YukiOrigane/Pneumatic_Measurement/部品表.xlsx

 | 品名 | 型番 | 仕様 | 員数 | 単位 | リンク | 購入元
1 | コンデンサ | 50PX100MEFC8X11.5 | 100uF50V | 3 | 個 | https://akizukidenshi.com/catalog/g/g117905/ | 秋月電子
2 | チップコンデンサ | GRM188F11H104ZA01 | 0.1uF50V | 1 | パック | https://akizukidenshi.com/catalog/g/g113374/ | 秋月電子 | 1パック40個入
3 | チップLED | OSTG1608C1A | 1608 | 1 | パック | https://akizukidenshi.com/catalog/g/g106417/ | 秋月電子 | 1パック20個入
4 | DCジャック | MJ-179PH | 2.1mm | 3 | 個 | https://akizukidenshi.com/catalog/g/g106568/ | 秋月電子
5 | ACアダプタ | AD-B240P100 | 24V1A | 1 | 個 | https://akizukidenshi.com/catalog/g/g110658/ | 秋月電子
6 | PHコネクタ | B4B-PH-K-S | トップ型 4P | 20 | 個 | https://akizukidenshi.com/catalog/g/g112804/ | 秋月電子
7 | PHコネクタ | PHR-4 | 4P | 20 | 個 | https://akizukidenshi.com/catalog/g/g112797/ | 秋月電子
8 | PHコネクタ | SPH-002T-P0.5L | SPH-002T-P0.5L | 2 | パック | https://akizukidenshi.com/catalog/g/g112837/ | 秋月電子
9 | PHコネクタ | PHR-5 | 5P | 20 | 個 | https://akizukidenshi.com/catalog/g/g112798/ | 秋月電子
10 | PHコネクタ | B5B-PH-K-S | トップ型 5P | 20 | 個 | https://akizukidenshi.com/catalog/g/g112805 | 秋月電子
11 | XHコネクタ | B2B-XH-A(LF)(SN) | トップ型 2P | 20 | 個 | https://akizukidenshi.com/catalog/g/g112247/ | 秋月電子
12 | XHコネクタ | XHP-2 | ２P | 20 | 個 | https://akizukidenshi.com/catalog/g/g112255/ | 秋月電子
13 | XHコネクタ | XHP-4 | 4P | 20 | 個 | https://akizukidenshi.com/catalog/g/g112257/ | 秋月電子
14 | XHコネクタ | B4B-XH-A(LF)(SN) | トップ型 4P | 20 | 個 | https://akizukidenshi.com/catalog/g/g112249/ | 秋月電子
15 | XHコネクタ | SXH-001T-P0.6 | SXH-001T-P0.6 | 1 | パック | https://akizukidenshi.com/catalog/g/g112265/ | 秋月電子
16 | NchMOSFET | BSS138 | 50V300mA | 1 | パック | https://akizukidenshi.com/catalog/g/g104232/ | 秋月電子 | 1パック25個入
17 | DAコンバーター | MCP4726A0T-E/CH | 12bit | 3 | 個 | https://akizukidenshi.com/catalog/g/g107611/ | 秋月電子
18 | 低損失レギュレーター | MCP1792T-5002H/CB | 5V100mA | 3 | 個 | https://akizukidenshi.com/catalog/g/g115756/ | 秋月電子
19 | チップ抵抗 | RK73B1JTTD104J | 1608 1/10W100kΩ | 1 | パック | https://akizukidenshi.com/catalog/g/g130357/ | 秋月電子 | 1パック100個入
20 | マイコンボード | CXD5602PWBMAIN1 | SONY SPRESENSE | 2 | 個 | https://akizukidenshi.com/catalog/g/g114584/ | 秋月電子
21 | マイコンボード | CXD5602PWBEXT1 | SONY SPRESENSE 拡張ボード | 2 | 個 | https://akizukidenshi.com/catalog/g/g114585/ | 秋月電子
22 | ピンソケット | FH-10+8-M | 10P+8P リード長14.3mm | 2 | 個 | https://akizukidenshi.com/catalog/g/g117102/ | 秋月電子
23 | ピンソケット | FH-8+6-M | 8P+6P リード長14.3mm | 2 | 個 | https://akizukidenshi.com/catalog/g/g117103/ | 秋月電子
24 | USBケーブル | USB CABLE A-MICROB(2A L0.5m) | USB2.0 Aオス-マイクロBオス 0.5m A-microB | 2 | 本 | https://akizukidenshi.com/catalog/g/g109314/ | 秋月電子
