YukiOrigane/Pneumatic_Measurement/circuit/回路図.pdf

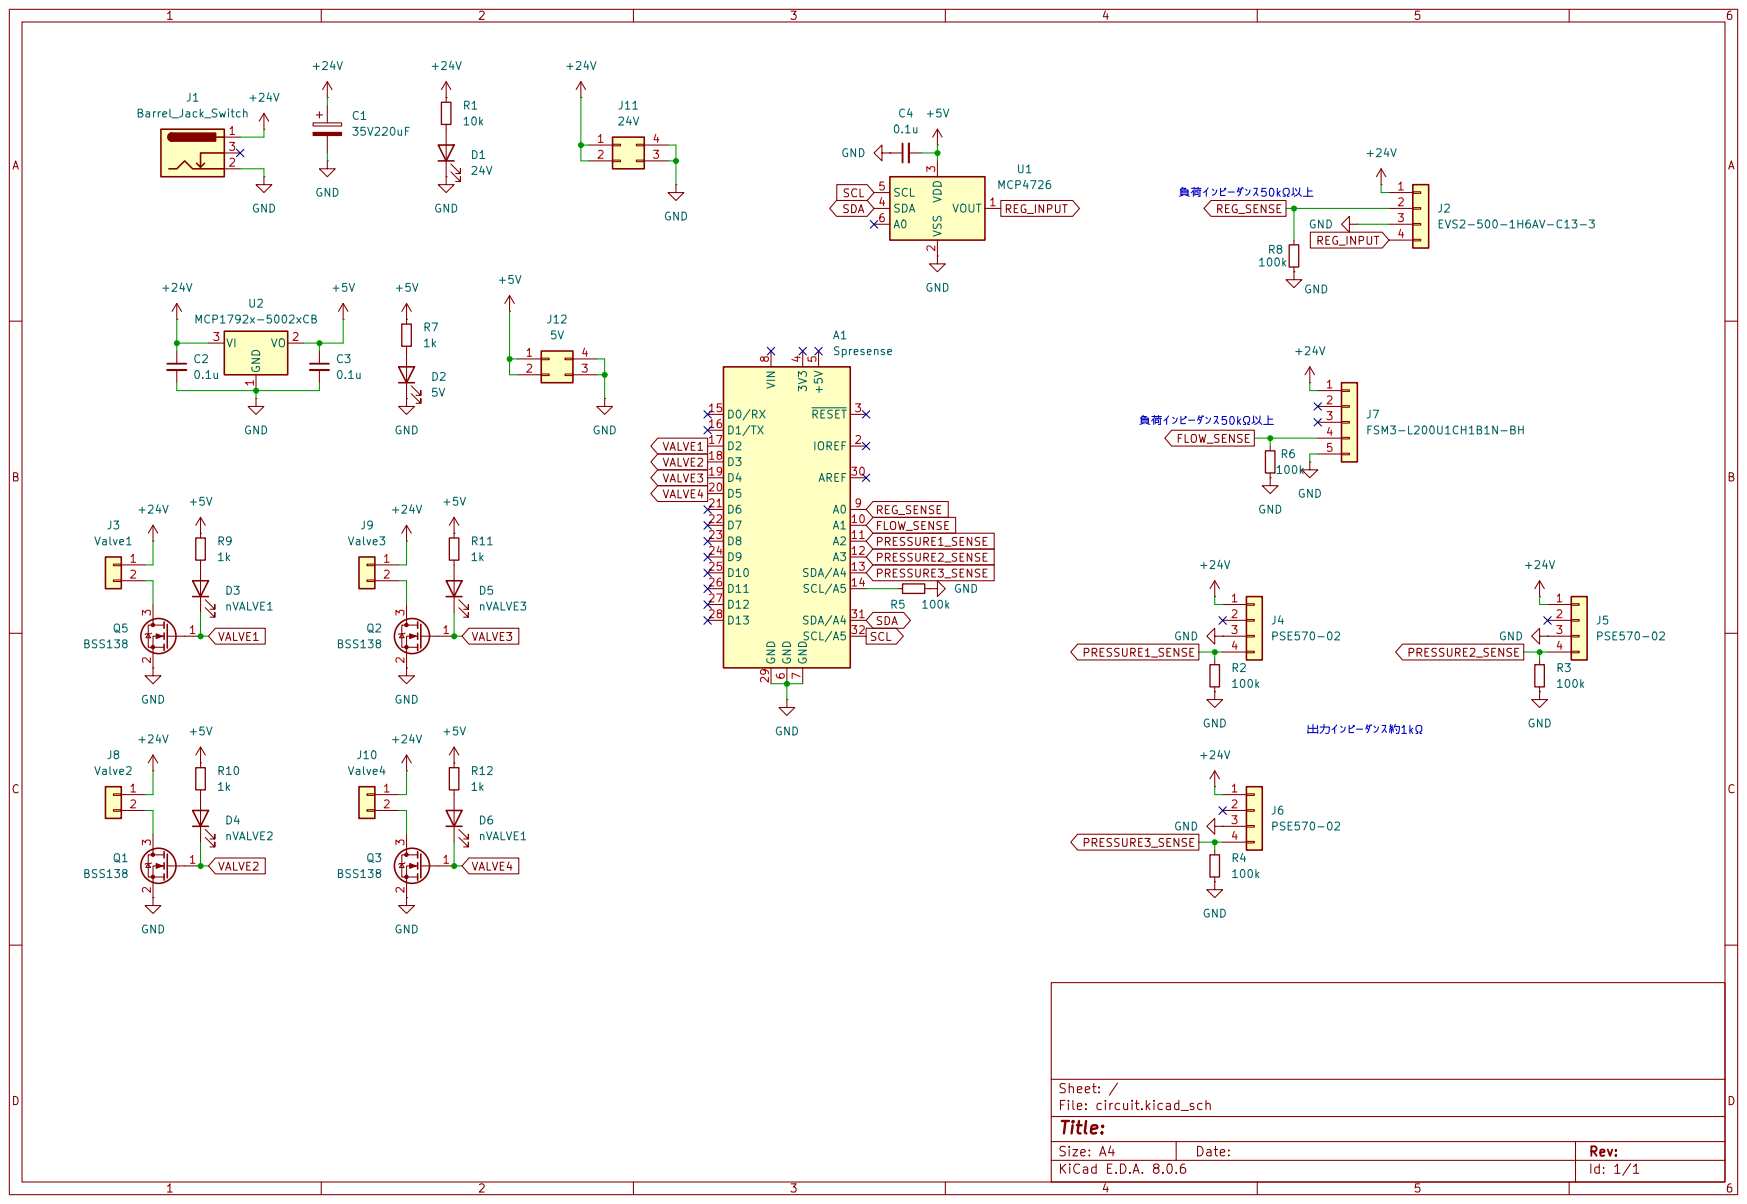
[picture p1: page 1]
